rajvi-patel-22/Liquid-Level-Control-using-Arduino/Project Photos/IMG_20171115_164218.jpg

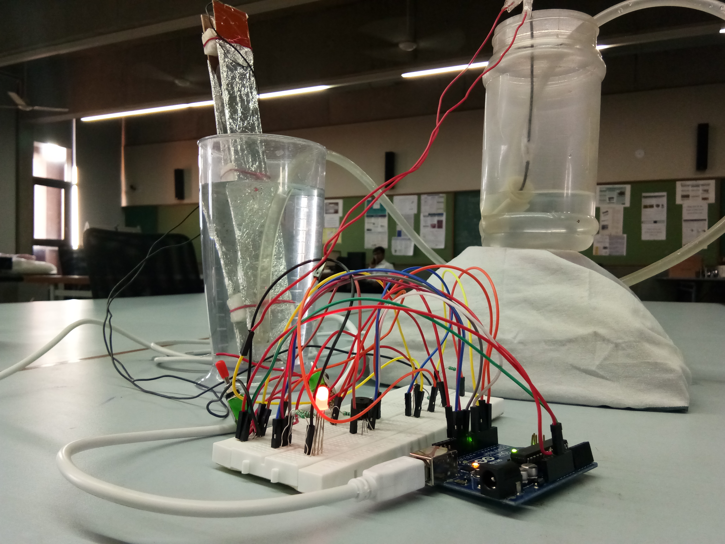
Project Photos/IMG_20171115_164218.jpg
