rajvi-patel-22/Liquid-Level-Control-using-Arduino/Project Photos/IMG_20171115_163956.jpg

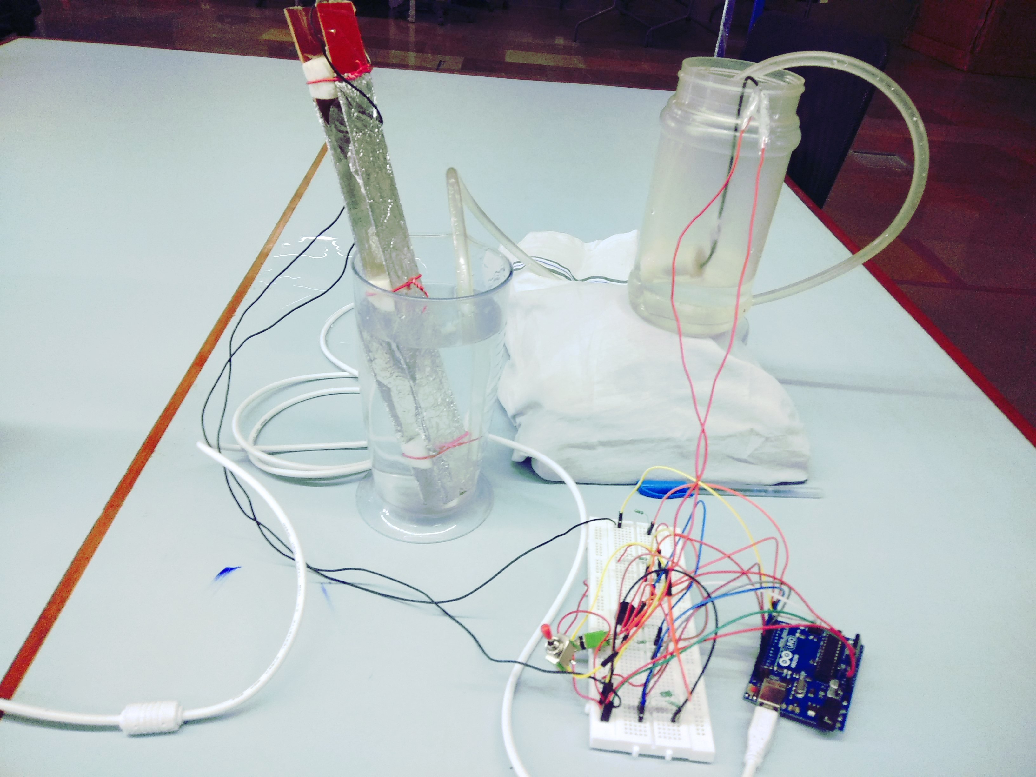
Project Photos/IMG_20171115_163956.jpg
